vohoangnguyennnn/riscv-rv32im-core/docs/release-checklist.md

# Release Checklist

This checklist records the gates closed for the published
[`v1.0.0` release](https://github.com/vohoangnguyennnn/riscv-rv32im-core/releases/tag/v1.0.0) of the FreeRTOS FPGA profile and serves as the
template for later releases. The authoritative evidence record is
[Hardware validation](hardware-validation.md).

## Completed engineering gates

- [x] Strict RTL lint, unit, directed integration, assertion, and software tests pass.
- [x] Pinned `riscv-tests` and Sail-backed ACT4 RV32I/RV32M suites pass.
- [x] FreeRTOS V11.3.0 runs on the production SoC model in Verilator and Questa.
- [x] Directed performance and CRC-valid CoreMark runs are recorded.
- [x] `freertos_demo.mem` is selected by the Vivado top-level generic.
- [x] The ten-port RTL/XDC board boundary appears in the post-route I/O report.
- [x] The 75 MHz implementation is fully routed and meets setup, hold, pulse-width, and DRC gates.
- [x] Firmware, reports, and bitstream are paired with SHA-256 hashes.
- [x] FreeRTOS boot, UART echo, GPIO, PASS/DONE, and reset behavior have been observed on board.

## Publication gates for `v1.0.0`

All publication gates closed on 2026-09-03.

- [x] Review and commit all intended source, third-party pinning, documentation, and CI changes.
- [x] Confirm `git status --short` is empty at the release commit.
- [x] Run the full release regression and save its console log.
- [x] Rebuild the 250 ms board FreeRTOS image from clean implementation commit `fc57a72`.
- [x] Re-run synthesis, implementation, and the FreeRTOS release export from that commit.
- [x] Program the exact exported `fpga_top.bit` and repeat the UART/GPIO/PASS/reset checks.
- [x] Record the implementation commit and replacement hashes in `hardware-validation.md`.
- [x] Tag `v1.0.0` and attach the Vivado evidence directory or a compressed copy to the GitHub release.

The `v1.0.0` tag points at commit `c8c4078`. Relative to implementation commit
`fc57a72`, it adds only documentation and benchmark-report-output packaging
changes; RTL, firmware, XDC, Clocking Wizard configuration, and the FPGA source
list are unchanged.

## Final commands

```sh
make -j"$(nproc)" test
make act4
make benchmark
make coremark
make fpga-freertos-images
git status --short
```

After `impl_1` completes in the matching Vivado project:

```tcl
set ::release_profile freertos
source {/absolute/path/to/scripts/vivado/export_release_reports.tcl}
```

The exporter writes `Report_vivado/freertos/<timestamp>/`. Do not tag the
release if the manifest reports a dirty source state or if the programmed
bitstream hash differs from that package. Any later change to RTL, software,
XDC, Clocking Wizard configuration, target part, or FPGA source list reopens
the implementation and board gates; documentation-only packaging changes do
not alter the recorded hardware artifact.
