vohoangnguyennnn/riscv-rv32im-core/rtl/core/ex_stage.sv

// RV32IM + Zicsr execute-stage datapath and control-transfer resolver.
//
// Pipeline storage remains in rv32_core. This stage applies forwarding, builds
// EX/MEM, performs CSR read-modify-write, and resolves control transfers.
// Redirects occur only when EX is accepted, preventing repeats under a hold.
// MUL/DIV requests wait behind older events and hold their response until the
// EX/MEM boundary accepts the instruction.
module ex_stage (
  input  logic                    clk_i,
  input  logic                    rst_i,
  input  logic                    kill_i,

  input  wire rv32_pkg::id_ex_t   id_ex_i,
  input  rv32_pkg::fwd_sel_e      fwd_a_sel_i,
  input  rv32_pkg::fwd_sel_e      fwd_b_sel_i,
  input  logic [31:0]             ex_mem_fwd_value_i,
  input  logic [31:0]             mem_wb_fwd_value_i,

  input  logic [31:0]             csr_rdata_i,
  input  logic [31:0]             csr_mepc_i,
  input  logic                    csr_access_illegal_i,
  input  logic                    result_ready_i,

  output logic [11:0]             csr_raddr_o,
  output logic                    csr_access_write_o,
  output wire rv32_pkg::ex_mem_t  ex_mem_o,
  output wire rv32_pkg::redirect_t control_redirect_o,
  output logic                    result_valid_o,
  output logic                    wait_o
);

  import rv32_pkg::*;

  word_t     forwarded_rs1;
  word_t     forwarded_rs2;
  word_t     alu_operand_a;
  word_t     alu_operand_b;
  word_t     alu_result;

  logic      branch_taken;
  word_t     branch_target;
  logic      branch_target_misaligned;

  logic      active;
  logic      is_csr;
  logic      is_mdu;
  logic      is_mul;
  logic      is_div;
  logic      is_control;
  logic      control_taken;
  word_t     control_target;
  logic      control_target_misaligned;
  logic      ex_fire;

  word_t     csr_wdata;
  logic      csr_write;

  logic      mul_req_valid;
  logic      mul_req_ready;
  logic      mul_rsp_valid;
  logic      mul_rsp_ready;
  word_t     mul_result;

  logic      div_req_valid;
  logic      div_req_ready;
  logic      div_rsp_valid;
  logic      div_rsp_ready;
  word_t     div_result;

  logic      mdu_rsp_valid;
  word_t     mdu_result;
  word_t     execution_result;

  ex_mem_t   ex_mem_d;
  redirect_t control_redirect_d;

  function automatic word_t select_forwarded_operand(
    input fwd_sel_e select,
    input word_t    regfile_value,
    input word_t    ex_mem_value,
    input word_t    mem_wb_value
  );
    begin
      unique case (select)
        FWD_EX_MEM: select_forwarded_operand = ex_mem_value;
        FWD_MEM_WB: select_forwarded_operand = mem_wb_value;
        default:    select_forwarded_operand = regfile_value;
      endcase
    end
  endfunction

  assign active     = id_ex_i.valid && !rst_i && !kill_i;
  assign is_csr     = (id_ex_i.ctrl.csr_cmd != CSR_NONE);
  assign is_mul     = (id_ex_i.ctrl.mdu_op == MDU_MUL) || (id_ex_i.ctrl.mdu_op == MDU_MULH) || (id_ex_i.ctrl.mdu_op == MDU_MULHSU) || (id_ex_i.ctrl.mdu_op == MDU_MULHU);
  assign is_div     = (id_ex_i.ctrl.mdu_op == MDU_DIV) || (id_ex_i.ctrl.mdu_op == MDU_DIVU) || (id_ex_i.ctrl.mdu_op == MDU_REM) || (id_ex_i.ctrl.mdu_op == MDU_REMU);
  // An incoming exception drains without launching a stale MDU request.
  assign is_mdu     = (is_mul || is_div) && !id_ex_i.exc.valid;
  assign is_control = (id_ex_i.ctrl.branch_kind != BR_NONE) || id_ex_i.ctrl.is_mret;

  always_comb begin
    forwarded_rs1 = select_forwarded_operand(
      fwd_a_sel_i,
      id_ex_i.rs1_value,
      ex_mem_fwd_value_i,
      mem_wb_fwd_value_i
    );

    forwarded_rs2 = select_forwarded_operand(
      fwd_b_sel_i,
      id_ex_i.rs2_value,
      ex_mem_fwd_value_i,
      mem_wb_fwd_value_i
    );
  end

  always_comb begin
    alu_operand_a = 32'b0;
    alu_operand_b = 32'b0;

    unique case (id_ex_i.ctrl.op_a_sel)
      OP_A_RS1:  alu_operand_a = forwarded_rs1;
      OP_A_PC:   alu_operand_a = id_ex_i.pc;
      OP_A_ZERO: alu_operand_a = 32'b0;
      default:   alu_operand_a = 32'b0;
    endcase

    unique case (id_ex_i.ctrl.op_b_sel)
      OP_B_RS2: alu_operand_b = forwarded_rs2;
      OP_B_IMM: alu_operand_b = id_ex_i.imm;
      default:  alu_operand_b = 32'b0;
    endcase
  end

  alu u_alu (
    .op_i     (id_ex_i.ctrl.alu_op),
    .a_i      (alu_operand_a),
    .b_i      (alu_operand_b),
    .result_o (alu_result)
  );

  branch_unit u_branch_unit (
    .kind_i       (id_ex_i.ctrl.branch_kind),
    .pc_i         (id_ex_i.pc),
    .imm_i        (id_ex_i.imm),
    .rs1_i        (forwarded_rs1),
    .rs2_i        (forwarded_rs2),
    .taken_o      (branch_taken),
    .target_o     (branch_target),
    .misaligned_o (branch_target_misaligned)
  );

  // result_ready_i also prevents MDU launch while an older event owns priority.
  assign mul_req_valid = active && is_mul && result_ready_i && mul_req_ready;
  assign div_req_valid = active && is_div && result_ready_i && div_req_ready;
  assign mul_rsp_ready = active && is_mul && result_ready_i;
  assign div_rsp_ready = active && is_div && result_ready_i;

  mul_unit u_mul_unit (
    .clk_i       (clk_i),
    .rst_i       (rst_i),
    .kill_i      (kill_i),
    .req_valid_i (mul_req_valid),
    .req_ready_o (mul_req_ready),
    .op_i        (id_ex_i.ctrl.mdu_op),
    .lhs_i       (forwarded_rs1),
    .rhs_i       (forwarded_rs2),
    .rsp_valid_o (mul_rsp_valid),
    .rsp_ready_i (mul_rsp_ready),
    .result_o    (mul_result)
  );

  div_unit u_div_unit (
    .clk_i       (clk_i),
    .rst_i       (rst_i),
    .kill_i      (kill_i),
    .req_valid_i (div_req_valid),
    .req_ready_o (div_req_ready),
    .op_i        (id_ex_i.ctrl.mdu_op),
    .lhs_i       (forwarded_rs1),
    .rhs_i       (forwarded_rs2),
    .rsp_valid_o (div_rsp_valid),
    .rsp_ready_i (div_rsp_ready),
    .result_o    (div_result)
  );

  always_comb begin
    mdu_rsp_valid   = 1'b0;
    mdu_result      = 32'b0;
    execution_result = alu_result;

    if (is_mul) begin
      mdu_rsp_valid = mul_rsp_valid;
      mdu_result    = mul_result;
    end else if (is_div) begin
      mdu_rsp_valid = div_rsp_valid;
      mdu_result    = div_result;
    end

    if (is_mdu) begin
      execution_result = mdu_result;
    end
  end

  // Immediate CSR forms use zimm; register forms use forwarded rs1.
  // CSRRS/RC[I] suppress the write when their mask is zero.
  always_comb begin
    csr_raddr_o        = 12'b0;
    csr_access_write_o = 1'b0;
    csr_wdata          = 32'b0;
    csr_write          = 1'b0;

    if (active && is_csr) begin
      csr_raddr_o = id_ex_i.insn[31:20];
    end

    unique case (id_ex_i.ctrl.csr_cmd)
      CSR_RW: begin
        csr_wdata   = forwarded_rs1;
        csr_write   = 1'b1;
      end

      CSR_RS: begin
        csr_wdata   = csr_rdata_i | forwarded_rs1;
        csr_write   = (id_ex_i.rs1 != 5'd0);
      end

      CSR_RC: begin
        csr_wdata   = csr_rdata_i & ~forwarded_rs1;
        csr_write   = (id_ex_i.rs1 != 5'd0);
      end

      CSR_RWI: begin
        csr_wdata   = {27'b0, id_ex_i.rs1};
        csr_write   = 1'b1;
      end

      CSR_RSI: begin
        csr_wdata   = csr_rdata_i | {27'b0, id_ex_i.rs1};
        csr_write   = (id_ex_i.rs1 != 5'd0);
      end

      CSR_RCI: begin
        csr_wdata   = csr_rdata_i & ~{27'b0, id_ex_i.rs1};
        csr_write   = (id_ex_i.rs1 != 5'd0);
      end

      default: begin
        csr_wdata   = 32'b0;
        csr_write   = 1'b0;
      end
    endcase

    csr_access_write_o = active && is_csr && csr_write;
  end

  always_comb begin
    control_taken  = branch_taken;
    control_target = branch_target;

    if (id_ex_i.ctrl.is_mret) begin
      control_taken  = 1'b1;
      control_target = csr_mepc_i;
    end

    // Rechecking the selected target extends branch_unit alignment checks to MRET.
    control_target_misaligned = id_ex_i.ctrl.is_mret ? (control_taken && (control_target[1:0] != 2'b00)) : branch_target_misaligned;

    // MDU results become valid with the selected response; valid is independent
    // of downstream ready.
    result_valid_o = active && (!is_mdu || mdu_rsp_valid);
    ex_fire        = result_valid_o && result_ready_i;
    wait_o         = active && !ex_fire;

    ex_mem_d = '0;

    if (result_valid_o) begin
      ex_mem_d.valid          = 1'b1;
      ex_mem_d.pc             = id_ex_i.pc;
      ex_mem_d.insn           = id_ex_i.insn;
      ex_mem_d.rd             = id_ex_i.rd;
      ex_mem_d.reg_write      = id_ex_i.ctrl.reg_write;
      ex_mem_d.wb_sel         = id_ex_i.ctrl.wb_sel;
      ex_mem_d.ex_result      = execution_result;
      ex_mem_d.store_data     = forwarded_rs2;
      ex_mem_d.mem_cmd        = id_ex_i.ctrl.mem_cmd;
      ex_mem_d.mem_size       = id_ex_i.ctrl.mem_size;
      ex_mem_d.load_unsigned  = id_ex_i.ctrl.load_unsigned;
      ex_mem_d.csr_addr       = is_csr ? id_ex_i.insn[31:20] : 12'b0;
      ex_mem_d.csr_write      = is_csr && csr_write;
      ex_mem_d.csr_wdata      = is_csr ? csr_wdata : 32'b0;
      ex_mem_d.csr_old        = is_csr ? csr_rdata_i : 32'b0;
      ex_mem_d.is_mret        = id_ex_i.ctrl.is_mret;
      ex_mem_d.control        = is_control;
      ex_mem_d.control_taken  = control_taken;
      ex_mem_d.control_target = control_target;
      ex_mem_d.exc            = id_ex_i.exc;

      // An exception already attached to the packet precedes EX-discovered faults.
      if (!ex_mem_d.exc.valid) begin
        if (is_csr && csr_access_illegal_i) begin
          ex_mem_d.exc.valid = 1'b1;
          ex_mem_d.exc.cause = EXC_ILLEGAL_INSN;
          ex_mem_d.exc.tval  = id_ex_i.insn;
        end else if (is_control && control_target_misaligned) begin
          ex_mem_d.exc.valid = 1'b1;
          ex_mem_d.exc.cause = EXC_INST_ADDR_MISALIGNED;
          ex_mem_d.exc.tval  = control_target;
        end
      end

      // Exception packets retain metadata but carry no architectural side effects.
      if (ex_mem_d.exc.valid) begin
        ex_mem_d.reg_write = 1'b0;
        ex_mem_d.mem_cmd   = MEM_NONE;
        ex_mem_d.csr_write = 1'b0;
        ex_mem_d.is_mret   = 1'b0;
      end
    end

    control_redirect_d = '0;

    if (ex_fire && is_control && control_taken && !ex_mem_d.exc.valid) begin
      control_redirect_d.valid  = 1'b1;
      control_redirect_d.target = control_target;
    end
  end

  assign ex_mem_o           = ex_mem_d;
  assign control_redirect_o = control_redirect_d;

endmodule
