vohoangnguyennnn/riscv-rv32im-core/rtl/core/rv32_pkg.sv

package rv32_pkg;

  localparam int XLEN       = 32;
  localparam int REG_ADDR_W = 5;
  localparam int CSR_ADDR_W = 12;

  typedef logic [XLEN-1:0]       word_t;
  typedef logic [REG_ADDR_W-1:0] reg_addr_t;
  typedef logic [CSR_ADDR_W-1:0] csr_addr_t;

  // Major opcodes
  localparam logic [6:0] OPCODE_LOAD     = 7'b000_0011;
  localparam logic [6:0] OPCODE_MISC_MEM = 7'b000_1111;
  localparam logic [6:0] OPCODE_OP_IMM   = 7'b001_0011;
  localparam logic [6:0] OPCODE_AUIPC    = 7'b001_0111;
  localparam logic [6:0] OPCODE_STORE    = 7'b010_0011;
  localparam logic [6:0] OPCODE_OP       = 7'b011_0011;
  localparam logic [6:0] OPCODE_LUI      = 7'b011_0111;
  localparam logic [6:0] OPCODE_BRANCH   = 7'b110_0011;
  localparam logic [6:0] OPCODE_JALR     = 7'b110_0111;
  localparam logic [6:0] OPCODE_JAL      = 7'b110_1111;
  localparam logic [6:0] OPCODE_SYSTEM   = 7'b111_0011;

  // OP and OP-IMM funct fields.
  localparam logic [2:0] FUNCT3_ADD_SUB = 3'b000;
  localparam logic [2:0] FUNCT3_SLL     = 3'b001;
  localparam logic [2:0] FUNCT3_SLT     = 3'b010;
  localparam logic [2:0] FUNCT3_SLTU    = 3'b011;
  localparam logic [2:0] FUNCT3_XOR     = 3'b100;
  localparam logic [2:0] FUNCT3_SRL_SRA = 3'b101;
  localparam logic [2:0] FUNCT3_OR      = 3'b110;
  localparam logic [2:0] FUNCT3_AND     = 3'b111;

  localparam logic [6:0] FUNCT7_BASE    = 7'b000_0000;
  localparam logic [6:0] FUNCT7_SUB_SRA = 7'b010_0000;
  localparam logic [6:0] FUNCT7_M       = 7'b000_0001;

  // Branch funct3 values.
  localparam logic [2:0] FUNCT3_BEQ  = 3'b000;
  localparam logic [2:0] FUNCT3_BNE  = 3'b001;
  localparam logic [2:0] FUNCT3_BLT  = 3'b100;
  localparam logic [2:0] FUNCT3_BGE  = 3'b101;
  localparam logic [2:0] FUNCT3_BLTU = 3'b110;
  localparam logic [2:0] FUNCT3_BGEU = 3'b111;

  // Load/store funct3 values.
  localparam logic [2:0] FUNCT3_LB  = 3'b000;
  localparam logic [2:0] FUNCT3_LH  = 3'b001;
  localparam logic [2:0] FUNCT3_LW  = 3'b010;
  localparam logic [2:0] FUNCT3_LBU = 3'b100;
  localparam logic [2:0] FUNCT3_LHU = 3'b101;

  localparam logic [2:0] FUNCT3_SB = 3'b000;
  localparam logic [2:0] FUNCT3_SH = 3'b001;
  localparam logic [2:0] FUNCT3_SW = 3'b010;

  localparam logic [2:0] FUNCT3_FENCE = 3'b000;
  localparam logic [2:0] FUNCT3_JALR  = 3'b000;

  // M-extension funct3 values. All use OPCODE_OP and FUNCT7_M.
  localparam logic [2:0] FUNCT3_MUL    = 3'b000;
  localparam logic [2:0] FUNCT3_MULH   = 3'b001;
  localparam logic [2:0] FUNCT3_MULHSU = 3'b010;
  localparam logic [2:0] FUNCT3_MULHU  = 3'b011;
  localparam logic [2:0] FUNCT3_DIV    = 3'b100;
  localparam logic [2:0] FUNCT3_DIVU   = 3'b101;
  localparam logic [2:0] FUNCT3_REM    = 3'b110;
  localparam logic [2:0] FUNCT3_REMU   = 3'b111;

  // SYSTEM funct3 values and exact privileged/system encodings.
  localparam logic [2:0] FUNCT3_PRIV   = 3'b000;
  localparam logic [2:0] FUNCT3_CSRRW  = 3'b001;
  localparam logic [2:0] FUNCT3_CSRRS  = 3'b010;
  localparam logic [2:0] FUNCT3_CSRRC  = 3'b011;
  localparam logic [2:0] FUNCT3_CSRRWI = 3'b101;
  localparam logic [2:0] FUNCT3_CSRRSI = 3'b110;
  localparam logic [2:0] FUNCT3_CSRRCI = 3'b111;

  localparam logic [31:0] INSN_ECALL  = 32'h0000_0073;
  localparam logic [31:0] INSN_EBREAK = 32'h0010_0073;
  localparam logic [31:0] INSN_MRET   = 32'h3020_0073;
  localparam logic [31:0] INSN_WFI    = 32'h1050_0073;

  // Datapath and decode controls
  typedef enum logic [3:0] {
    ALU_NONE,
    ALU_ADD,
    ALU_SUB,
    ALU_SLL,
    ALU_SRL,
    ALU_SRA,
    ALU_SLT,
    ALU_SLTU,
    ALU_XOR,
    ALU_OR,
    ALU_AND
  } alu_op_e;

  typedef enum logic [2:0] {
    IMM_NONE,
    IMM_I,
    IMM_S,
    IMM_B,
    IMM_U,
    IMM_J
  } imm_sel_e;

  typedef enum logic [1:0] {
    OP_A_RS1,
    OP_A_PC,
    OP_A_ZERO
  } op_a_sel_e;

  typedef enum logic {
    OP_B_RS2,
    OP_B_IMM
  } op_b_sel_e;

  typedef enum logic [1:0] {
    WB_EX_RESULT,
    WB_LOAD,
    WB_PC4,
    WB_CSR
  } wb_sel_e;

  typedef enum logic [3:0] {
    BR_NONE,
    BR_BEQ,
    BR_BNE,
    BR_BLT,
    BR_BGE,
    BR_BLTU,
    BR_BGEU,
    BR_JAL,
    BR_JALR
  } branch_e;

  typedef enum logic [1:0] {
    MEM_NONE,
    MEM_LOAD,
    MEM_STORE
  } mem_cmd_e;

  typedef enum logic [1:0] {
    MEM_BYTE,
    MEM_HALF,
    MEM_WORD
  } mem_size_e;

  typedef enum logic [3:0] {
    MDU_NONE,
    MDU_MUL,
    MDU_MULH,
    MDU_MULHSU,
    MDU_MULHU,
    MDU_DIV,
    MDU_DIVU,
    MDU_REM,
    MDU_REMU
  } mdu_op_e;

  typedef enum logic [2:0] {
    CSR_NONE,
    CSR_RW,
    CSR_RS,
    CSR_RC,
    CSR_RWI,
    CSR_RSI,
    CSR_RCI
  } csr_cmd_e;

  typedef enum logic [1:0] {
    FWD_REGFILE,
    FWD_EX_MEM,
    FWD_MEM_WB
  } fwd_sel_e;

  // M-only CSR subset: MPP has the single legal value M and MTIP/MTIE are the
  // only implemented interrupt pending/enable bits.
  /* verilator lint_off UNUSEDPARAM */
  localparam csr_addr_t CSR_MSTATUS    = 12'h300;
  localparam csr_addr_t CSR_MISA       = 12'h301;
  localparam csr_addr_t CSR_MIE        = 12'h304;
  localparam csr_addr_t CSR_MTVEC      = 12'h305;
  localparam csr_addr_t CSR_MSCRATCH   = 12'h340;
  localparam csr_addr_t CSR_MEPC       = 12'h341;
  localparam csr_addr_t CSR_MCAUSE     = 12'h342;
  localparam csr_addr_t CSR_MTVAL      = 12'h343;
  localparam csr_addr_t CSR_MIP        = 12'h344;
  localparam csr_addr_t CSR_MCYCLE     = 12'hb00;
  localparam csr_addr_t CSR_MINSTRET   = 12'hb02;
  localparam csr_addr_t CSR_MCYCLEH    = 12'hb80;
  localparam csr_addr_t CSR_MINSTRETH  = 12'hb82;
  localparam csr_addr_t CSR_MVENDORID  = 12'hf11;
  localparam csr_addr_t CSR_MARCHID    = 12'hf12;
  localparam csr_addr_t CSR_MIMPID     = 12'hf13;
  localparam csr_addr_t CSR_MHARTID    = 12'hf14;
  localparam csr_addr_t CSR_MCONFIGPTR = 12'hf15;

  localparam word_t MISA_RV32IM = 32'h4000_1100;

  // MPP is single-value WARL=M; only MIE/MPIE are writable state.
  localparam int unsigned MSTATUS_MIE_BIT  = 3;
  localparam int unsigned MSTATUS_MPIE_BIT = 7;
  localparam int unsigned MSTATUS_MPP_LSB  = 11;
  localparam int unsigned MSTATUS_MPP_MSB  = 12;

  localparam word_t MSTATUS_MIE_MASK         = 32'h0000_0008;
  localparam word_t MSTATUS_MPIE_MASK        = 32'h0000_0080;
  localparam word_t MSTATUS_MPP_MASK         = 32'h0000_1800;
  localparam word_t MSTATUS_MPP_M_VALUE      = 32'h0000_1800;
  localparam word_t MSTATUS_IMPLEMENTED_MASK = MSTATUS_MIE_MASK
                                                | MSTATUS_MPIE_MASK
                                                | MSTATUS_MPP_MASK;
  localparam word_t MSTATUS_WRITABLE_MASK    = MSTATUS_MIE_MASK
                                                | MSTATUS_MPIE_MASK;
  localparam word_t MSTATUS_RESET_VALUE      = MSTATUS_MPP_M_VALUE;

  // mie/mip share standard bit positions. MSIP/MEIP are RO0; MTIP is the live,
  // read-only timer-comparator level.
  localparam int unsigned MINT_MSIP_BIT = 3;
  localparam int unsigned MINT_MTIP_BIT = 7;
  localparam int unsigned MINT_MEIP_BIT = 11;

  localparam word_t MIE_MSIE_MASK        = 32'h0000_0008;
  localparam word_t MIE_MTIE_MASK        = 32'h0000_0080;
  localparam word_t MIE_MEIE_MASK        = 32'h0000_0800;
  localparam word_t MIE_IMPLEMENTED_MASK = MIE_MTIE_MASK;
  localparam word_t MIE_WRITABLE_MASK    = MIE_MTIE_MASK;
  localparam word_t MIE_RESET_VALUE      = 32'b0;

  localparam word_t MIP_MSIP_MASK        = 32'h0000_0008;
  localparam word_t MIP_MTIP_MASK        = 32'h0000_0080;
  localparam word_t MIP_MEIP_MASK        = 32'h0000_0800;
  localparam word_t MIP_IMPLEMENTED_MASK = MIP_MTIP_MASK;
  localparam word_t MIP_WRITABLE_MASK    = 32'b0;

  // mcause[XLEN-1] distinguishes interrupts; five code bits cover this scope.
  localparam int unsigned TRAP_CAUSE_W = 5;
  typedef logic [TRAP_CAUSE_W-1:0] trap_cause_t;

  localparam int unsigned MCAUSE_INTERRUPT_BIT  = XLEN - 1;
  localparam word_t       MCAUSE_INTERRUPT_MASK = 32'h8000_0000;
  localparam word_t       MCAUSE_CODE_MASK      = 32'h0000_001f;
  localparam trap_cause_t IRQ_M_TIMER_CAUSE     = 5'd7;
  localparam word_t       MCAUSE_M_TIMER_VALUE  = 32'h8000_0007;
  /* verilator lint_on UNUSEDPARAM */

  // Standard synchronous exception cause values.
  typedef enum trap_cause_t {
    EXC_INST_ADDR_MISALIGNED  = 5'd0,
    EXC_INST_ACCESS_FAULT     = 5'd1,
    EXC_ILLEGAL_INSN          = 5'd2,
    EXC_BREAKPOINT            = 5'd3,
    EXC_LOAD_ADDR_MISALIGNED  = 5'd4,
    EXC_LOAD_ACCESS_FAULT     = 5'd5,
    EXC_STORE_ADDR_MISALIGNED = 5'd6,
    EXC_STORE_ACCESS_FAULT    = 5'd7,
    EXC_ECALL_M               = 5'd11
  } exc_cause_e;

  // Shared control and pipeline bundles
  typedef struct packed {
    logic  valid;
    word_t target;
  } redirect_t;

  typedef struct packed {
    logic       valid;
    logic       is_interrupt;
    exc_cause_e cause;
    word_t      tval;
  } exc_t;

  typedef struct packed {
    logic      uses_rs1;
    logic      uses_rs2;
    logic      reg_write;
    alu_op_e   alu_op;
    op_a_sel_e op_a_sel;
    op_b_sel_e op_b_sel;
    wb_sel_e   wb_sel;
    branch_e   branch_kind;
    mem_cmd_e  mem_cmd;
    mem_size_e mem_size;
    logic      load_unsigned;
    mdu_op_e   mdu_op;
    csr_cmd_e  csr_cmd;
    logic      is_mret;
    logic      is_fence;
  } decode_ctrl_t;

  typedef struct packed {
    logic valid;
    word_t pc;
    word_t insn;
    exc_t exc;
  } if_id_t;

  typedef struct packed {
    logic         valid;
    word_t        pc;
    word_t        insn;
    reg_addr_t    rs1;
    reg_addr_t    rs2;
    reg_addr_t    rd;
    word_t        rs1_value;
    word_t        rs2_value;
    word_t        imm;
    decode_ctrl_t ctrl;
    exc_t         exc;
  } id_ex_t;

  typedef struct packed {
    logic      valid;
    word_t     pc;
    word_t     insn;
    reg_addr_t rd;
    logic      reg_write;
    wb_sel_e   wb_sel;
    word_t     ex_result;
    word_t     store_data;
    mem_cmd_e  mem_cmd;
    mem_size_e mem_size;
    logic      load_unsigned;
    csr_addr_t csr_addr;
    logic      csr_write;
    word_t     csr_wdata;
    word_t     csr_old;
    logic      is_mret;
    logic      control;
    logic      control_taken;
    word_t     control_target;
    exc_t      exc;
  } ex_mem_t;

  typedef struct packed {
    logic      valid;
    word_t     pc;
    word_t     insn;
    reg_addr_t rd;
    logic      reg_write;
    word_t     wb_data;
    logic      csr_write;
    csr_addr_t csr_addr;
    word_t     csr_wdata;
    logic      is_mret;
    logic      mem_write;
    word_t     mem_addr;
    logic [3:0] mem_wstrb;
    word_t     mem_wdata;
    logic      control;
    logic      control_taken;
    word_t     control_target;
    exc_t      exc;
  } mem_wb_t;

endpackage
