vohoangnguyennnn/riscv-rv32im-core/tb/assertions/rv32_core_interrupt_sva.sv

// Precise machine-timer interrupt invariants at the ID/EX acceptance boundary.
// This checker deliberately distinguishes a combinational interrupt candidate
// from a packet accepted by the pipeline controller: an older wait, exception,
// or redirect is allowed to reject the candidate and retry the level later.
module rv32_core_interrupt_sva (
  input logic        clk_i,
  input logic        rst_i,
  input logic        interrupt_candidate_i,
  input logic        interrupt_event_i,
  input logic        interrupt_accept_i,
  input logic        irq_eligible_i,
  input logic        irq_eligible_before_commit_i,
  input logic        irq_eligible_after_commit_i,
  input logic        mem_wb_irq_state_writer_i,
  input logic        irq_state_ambiguous_i,
  input logic        trap_drain_i,
  input logic        candidate_valid_i,
  input logic        candidate_exc_valid_i,
  input logic [31:0] candidate_pc_i,
  input logic        id_ex_valid_i,
  input logic [31:0] id_ex_pc_i,
  input logic [31:0] id_ex_insn_i,
  input logic        id_ex_exc_valid_i,
  input logic        id_ex_exc_interrupt_i,
  input logic [4:0]  id_ex_exc_cause_i,
  input logic [31:0] id_ex_exc_tval_i,
  input logic        id_ex_ctrl_zero_i
);

  property p_candidate_requires_effective_eligibility;
    @(posedge clk_i)
    disable iff (rst_i)
    interrupt_candidate_i |-> irq_eligible_i
                              && !irq_state_ambiguous_i
                              && !trap_drain_i;
  endproperty

  property p_enable_commit_builds_immediate_candidate;
    @(posedge clk_i)
    disable iff (rst_i)
    mem_wb_irq_state_writer_i
      && !irq_eligible_before_commit_i
      && irq_eligible_after_commit_i
      && candidate_valid_i
      && !candidate_exc_valid_i
      && !irq_state_ambiguous_i
      && !trap_drain_i
        |-> interrupt_candidate_i;
  endproperty
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
