vohoangnguyennnn/riscv-rv32im-core/(commit log)

2026-07-26 feat(rtl): add request-response memory interface
    - define request and response channels
    - support byte write strobes and error responses
    - provide master and slave modports
    [rv32_mem_if.sv]
2026-07-27 feat(tcm): implement unified dual-port tightly coupled memory
    [rv32_tcm.sv]
2026-07-28 feat(if): implement redirect-safe instruction fetch stage
2026-07-29 feat(core): implement ID stage
2026-08-09 fix(core): preserve forwarded operands during pipeline stalls
    [rv32_core.sv]
2026-08-10 fix(alu): add deterministic default result
    [alu.sv]
2026-08-10 refactor(div): simplify signed result correction logic
    [div_unit.sv]
2026-08-11 feat(fpga): add RV32IM FPGA top and reset synchronizer
    [fpga_top.sv, reset_sync.sv]
2026-08-11 test(fpga): add reset and top-level smoke tests
    [tb_reset_sync.sv]
2026-08-11 build(fpga): add board constraints and implementation reporting
2026-08-14 test(tb): add shared instruction encoders and delayed memory model
2026-08-14 feat(sw): add bare-metal runtime and smoke test build flow
2026-08-16 test(act4): add RTL compliance regression flow
2026-08-18 fix(tcm): size byte-count parameter explicitly
    [rv32_tcm.sv]
2026-08-18 fix(tcm): avoid parameter concatenation warning
    [rv32_tcm.sv]
2026-08-23 perf(div): add small-magnitude early-out
    Return quotient zero or the original remainder when the dividend magnitude is smaller than the divisor, avoiding unnecessary division iterations.
    [div_unit.sv]
2026-08-23 perf(csr): remove false stalls between independent CSR accesses
    Serialize CSR operations only when their architectural addresses conflict while preserving counter high/low alias dependencies.
    [hazard_unit.sv]
2026-08-23 refactor(control): remove unused redirect origin metadata
    Remove the unused ID redirect origin and retain unconditional ID/EX flushing for execute-stage redirects.
2026-08-23 feat(perf): expose pipeline performance event counters
    Add non-architectural counters for cycles, retired instructions, stalls, redirects, and squashed pipeline packets.
    [rv32_core.sv, soc_tcm_top.sv]
2026-08-23 feat(fpga): integrate 75 MHz Clocking Wizard
    Run the TCM-based SoC from the generated 75 MHz clock and hold reset until the clock generator reports lock.
    [fpga_top.sv]
2026-08-24 feat(soc): integrate TCM timer UART GPIO and MMIO fabric
2026-08-24 feat(fpga): finalize clock reset and board-level SoC integration
    [fpga_top.sv, reset_sync.sv]
2026-08-24 fix(lsu): drain outstanding response across reset
    Preserve LSU_BUSY for an accepted transaction during reset, discard its delayed response before accepting new work, and add reset-drain regression coverage.
    [lsu.sv, tb_lsu.sv]
2026-08-26 fpga: update board pin and timing constraints
    Add user reset, CH340 UART, and external GPIO LED pin assignments while relying on the Clocking Wizard generated clock constraint.
    [main.xdc]
2026-08-26 test: expand unit coverage for core and SoC components
    Cover CSR and MRET state transitions, precise interrupt control, CSR hazards, divider corner cases, WFI decoding, timer behavior, UART TX/RX, GPIO registers, and MMIO demux ownership.
2026-08-27 test: expand integration and assertion coverage
    Add precise control-flow, timer-interrupt, FreeRTOS SoC, retirement, and memory-protocol checks while extending CSR, forwarding, backpressure, bare-metal, and MMIO scenarios.
2026-08-27 fpga: connect board reset, UART, and GPIO interfaces
    Add the user SoC reset input, route CH340 UART RX/TX through the SoC, expose GPIO bit zero, and hold external outputs benign during reset or clock unlock.
    [fpga_top.sv]
2026-08-27 build: update RTL and verification source manifests
    Add timer, UART, GPIO, and memory-demux sources and register the corresponding unit, interrupt, control-flow, SoC, and FreeRTOS integration testbenches.
2026-08-27 sim: extend Questa debug and waveform flows
    Add curated waveforms for control flow, precise timer interrupts, MMIO demux, and FreeRTOS execution together with reproducible capture ranges and expanded SoC visibility.
2026-08-30 software: add RV32 SoC board support package
    Define the timer, UART, GPIO, and completion-mailbox MMIO interface and provide low-level peripheral access routines.
2026-08-30 software: add FreeRTOS machine-mode port and demo
    Add startup, linker layout, kernel configuration, timer integration, platform hooks, GPIO blink tasks, and UART echo execution.
2026-09-01 fpga: add reproducible Clocking Wizard creation script
    Create the FPGA clock IP that derives the 75 MHz SoC clock from the board's 50 MHz oscillator.
2026-09-01 fpga: expand implementation evidence collection
    Collect timing, utilization, power, DRC, run properties, source provenance, implementation artifacts, and SHA-256 manifests from the opened Vivado design.
2026-11-01 fix(build): rebuild FreeRTOS objects when configuration changes
    Track compiler and FreeRTOS flags in a content-stable configuration stamp. Check clock/blink rebuilds and unchanged timestamps in an isolated cache as part of make test. The missing-FORCE mutant fails; full regression and the separate -B board-image build pass.
2026-11-03 docs(fpga): update Vivado timing, utilization, power and device captures
2026-11-03 docs(validation): sync timing/utilization/power and mark v1.0.0 results as archived
