vohoangnguyennnn/riscv-rv32im-core/(notices)

Notices in the files:
README.md:
License: MIT
